filipleon54/hellen-example/boards/lewycustom-a/board/lewycustom-a.png

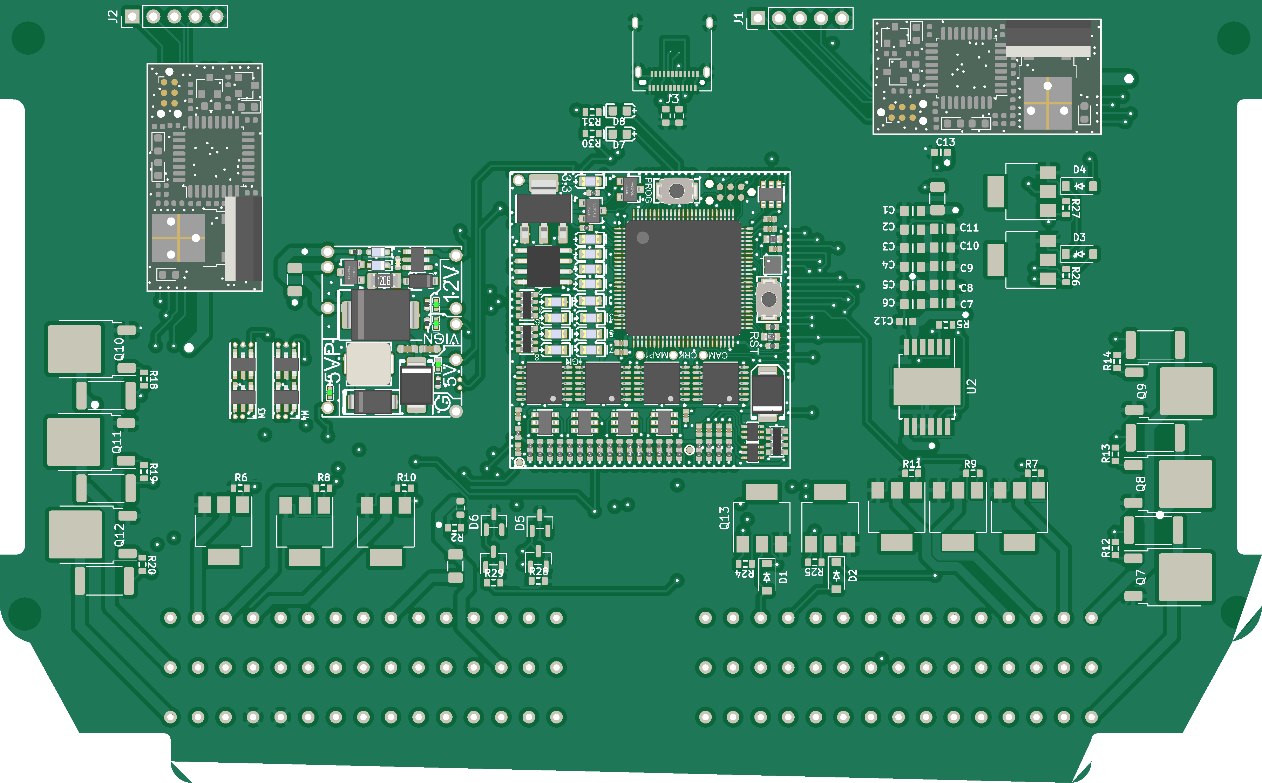
boards/lewycustom-a/board/lewycustom-a.png
