filipleon54/hellen-example/boards/lewycustom-a/board/misc/lewycustom-a-bottom.png

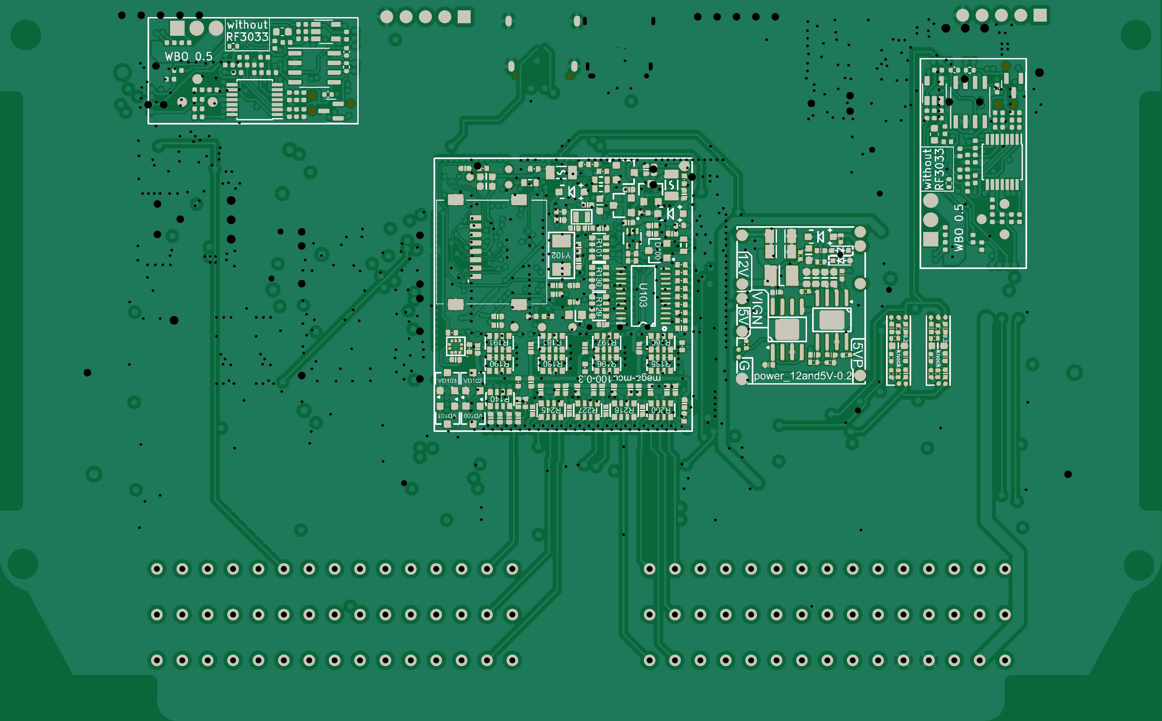
boards/lewycustom-a/board/misc/lewycustom-a-bottom.png
