filipleon54/hellen-example/boards/lewycustom-a/board/misc/lewycustom-a-outline.png

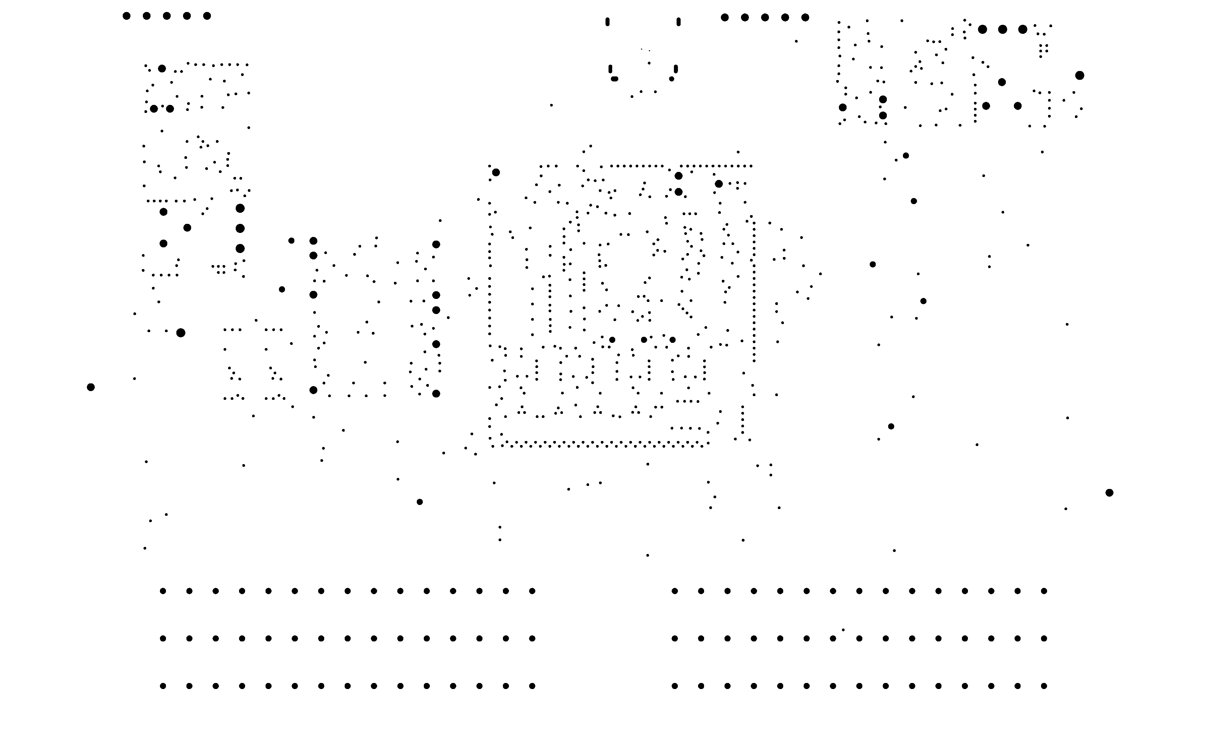
boards/lewycustom-a/board/misc/lewycustom-a-outline.png
