filipleon54/hellen-example/boards/lewycustom-a/board/misc/lewycustom-a-top.png

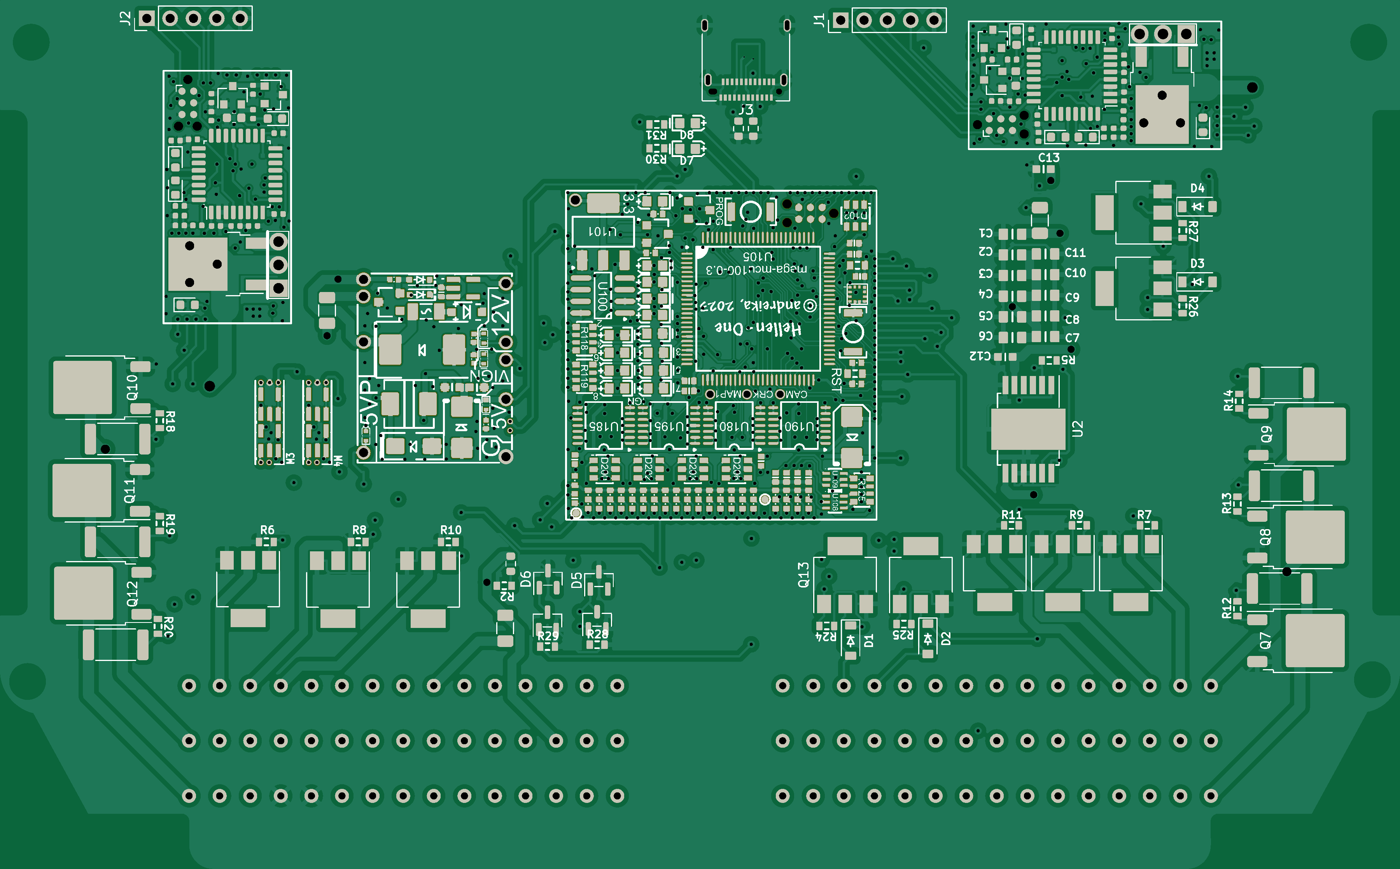
boards/lewycustom-a/board/misc/lewycustom-a-top.png
