filipleon54/hellen-example/boards/lewycustom-a/board/misc/lewycustom-a-components.png

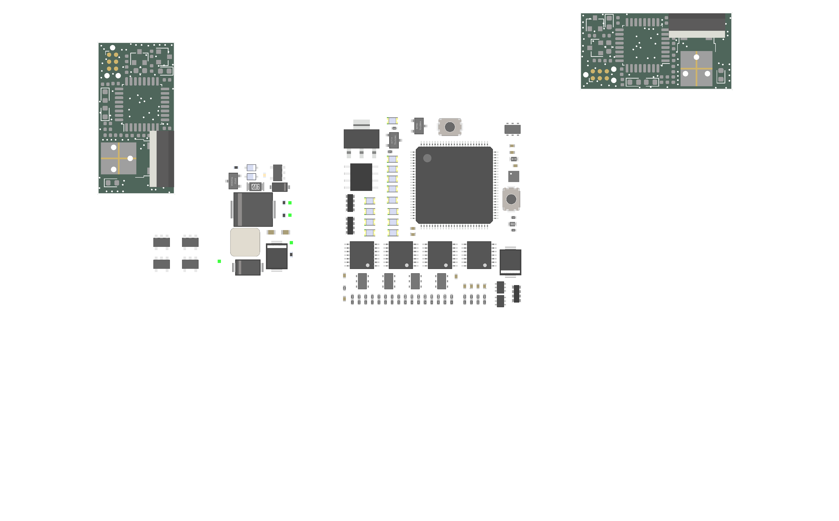
boards/lewycustom-a/board/misc/lewycustom-a-components.png
