filipleon54/hellen-example/boards/lewycustom-a/board/lewycustom-a-schematic.pdf

# File: ign.kicad_sch OUT- OUT+

# +5VA GND

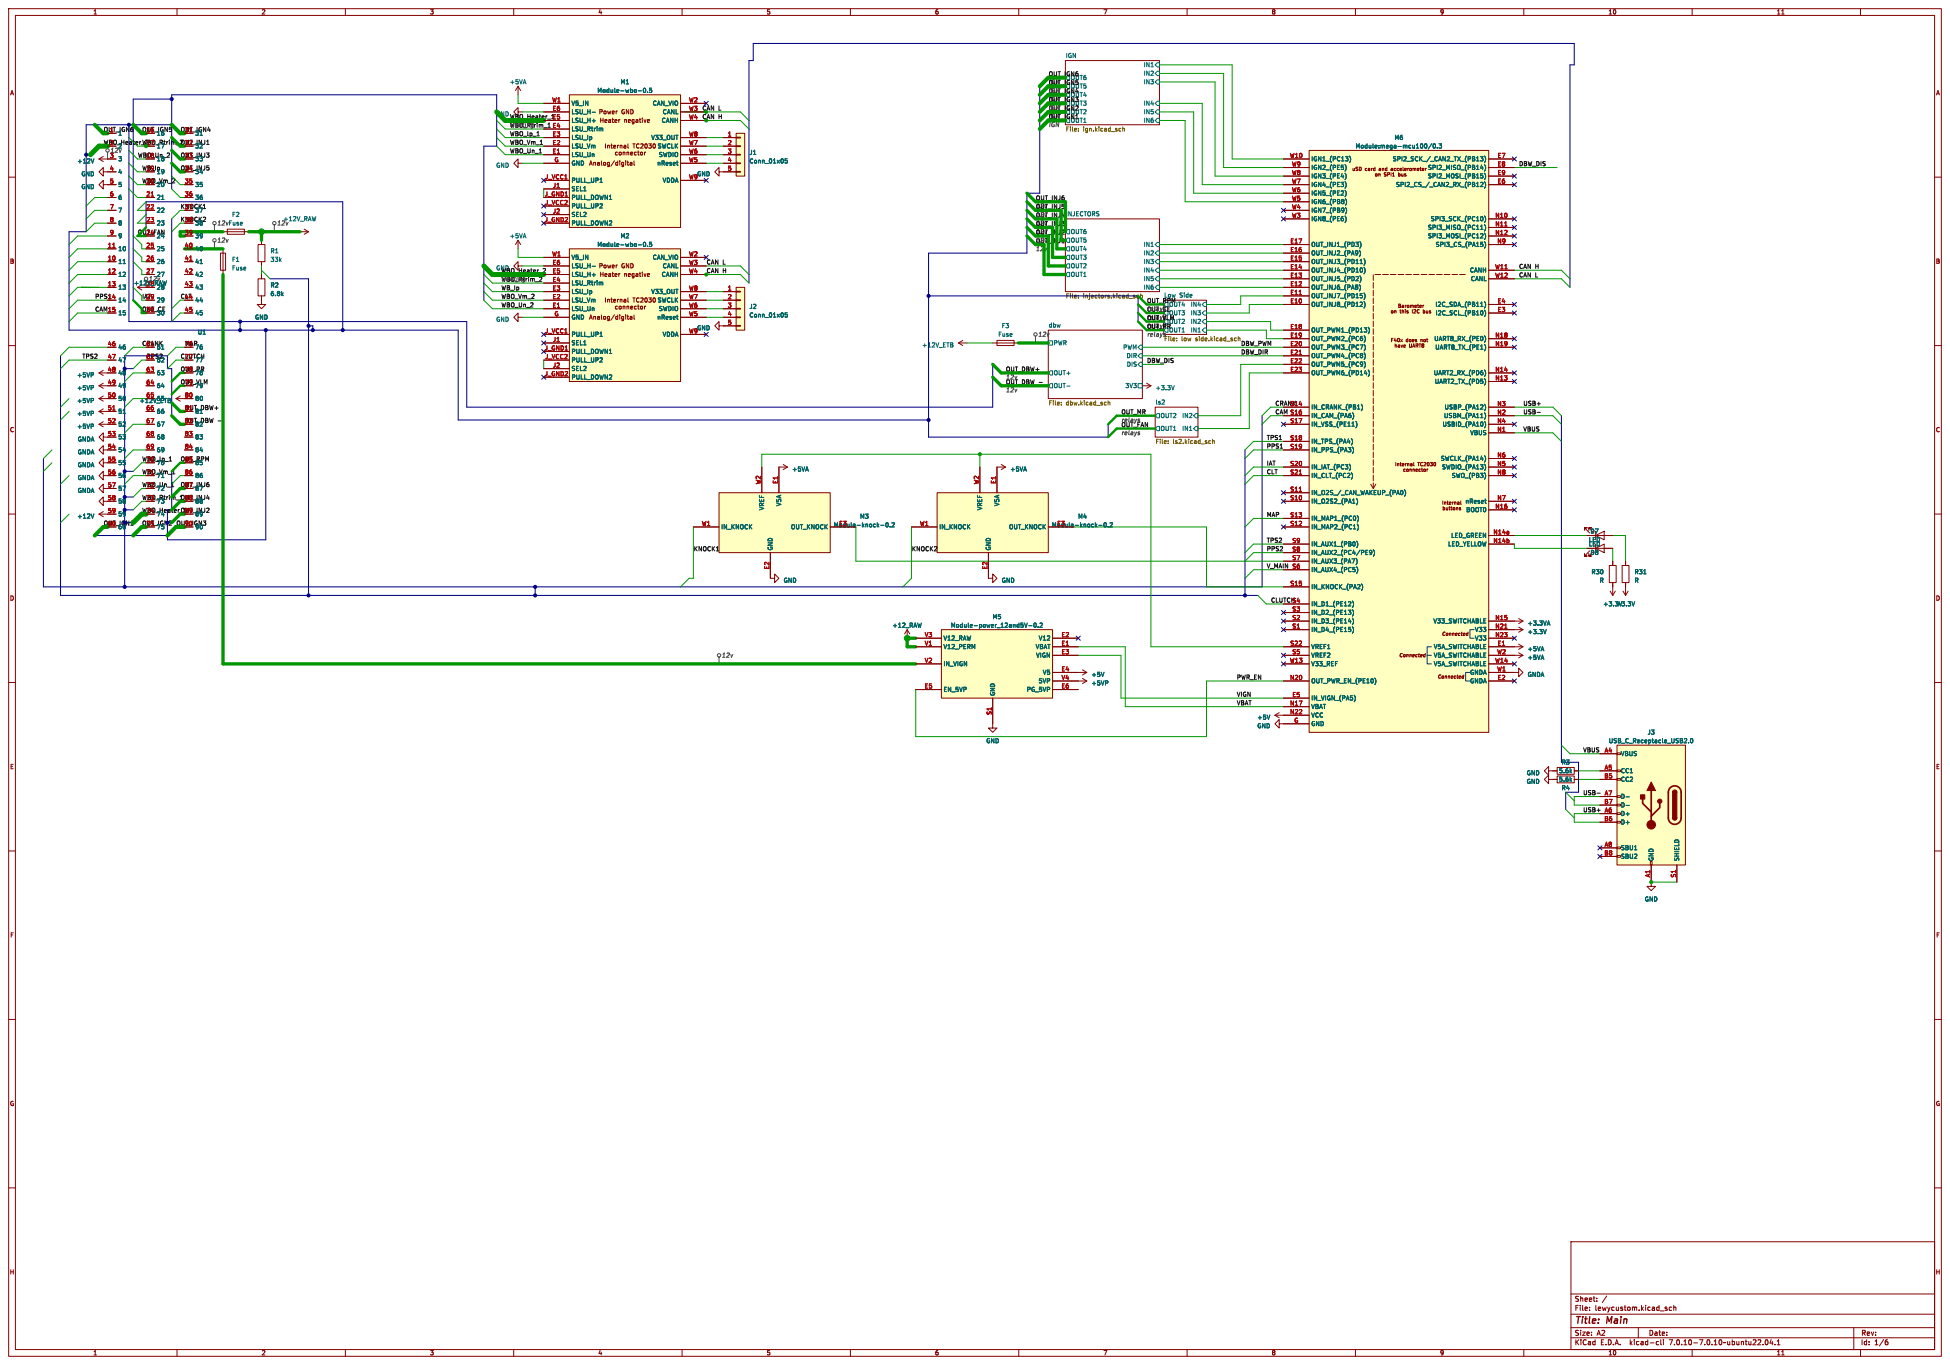
[picture p6: page 1]

F3 Fuse Analog/digital Heater negative Power GND

Low Side File: low side.kicad_sch OUT1

Analog/digital Heater negative Power GND

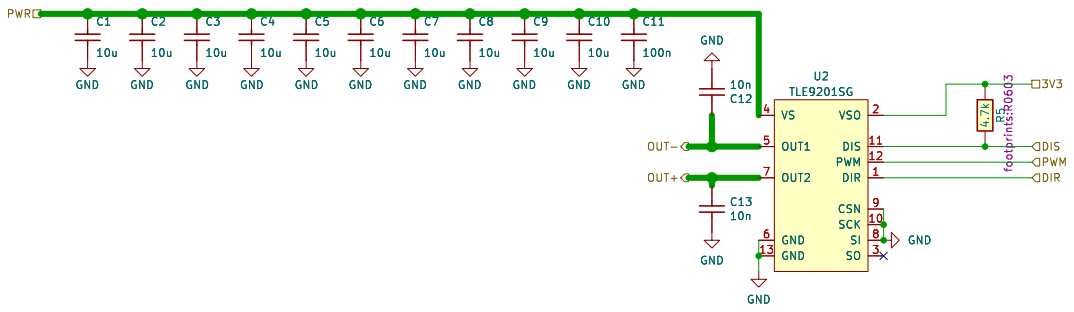
[picture p7: page 2]

Id: 2/6 Title: File: dbw.kicad_sch Sheet: /dbw/

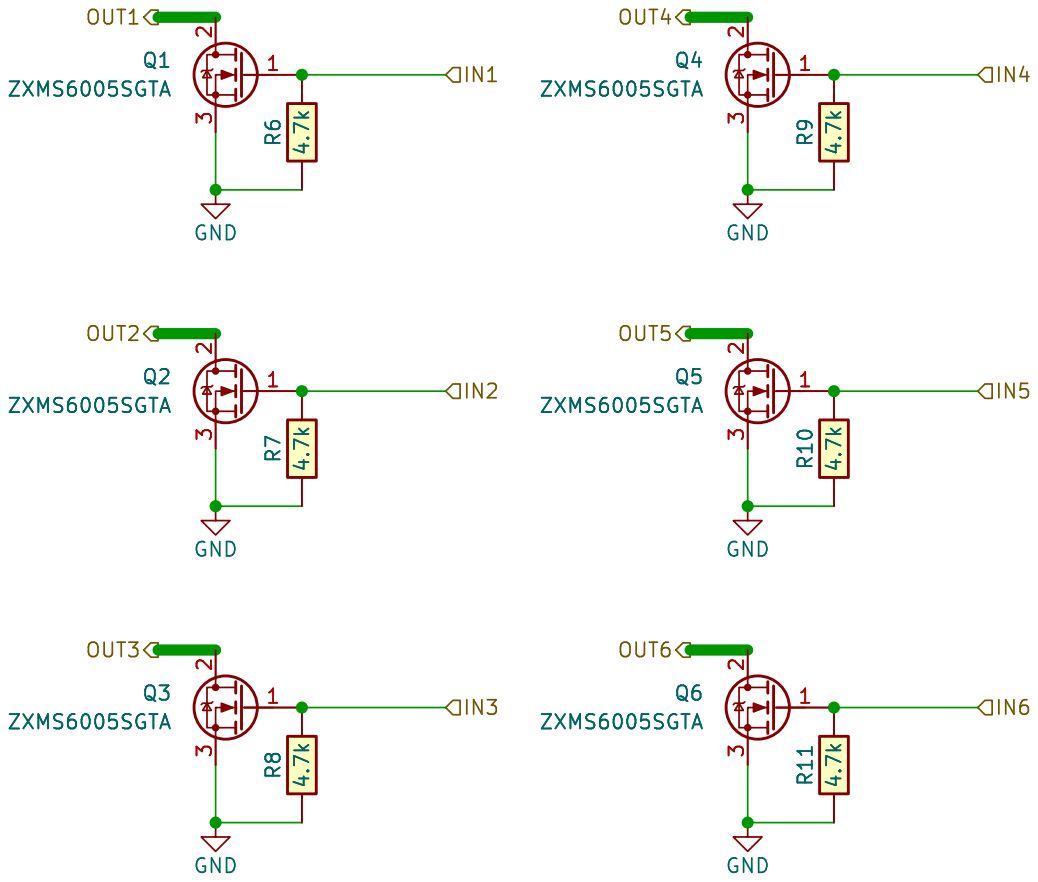
[picture p8: page 3]

Id: 3/6 Title: File: injectors.kicad_sch Sheet: /INJECTORS/ GND R⁶ 4.7k R⁷ 4.7k 1

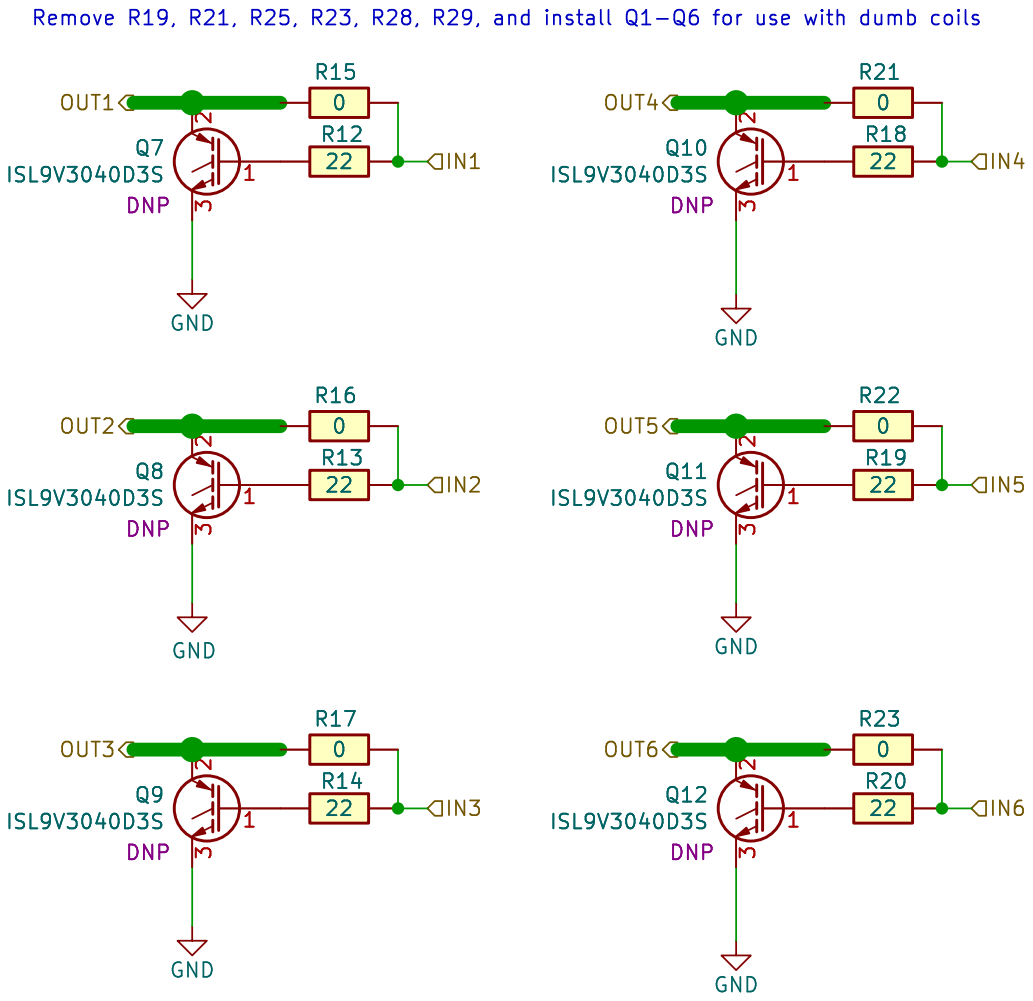
[picture p9: page 4]

Id: 4/6 Title: File: ign.kicad_sch Sheet: /IGN/

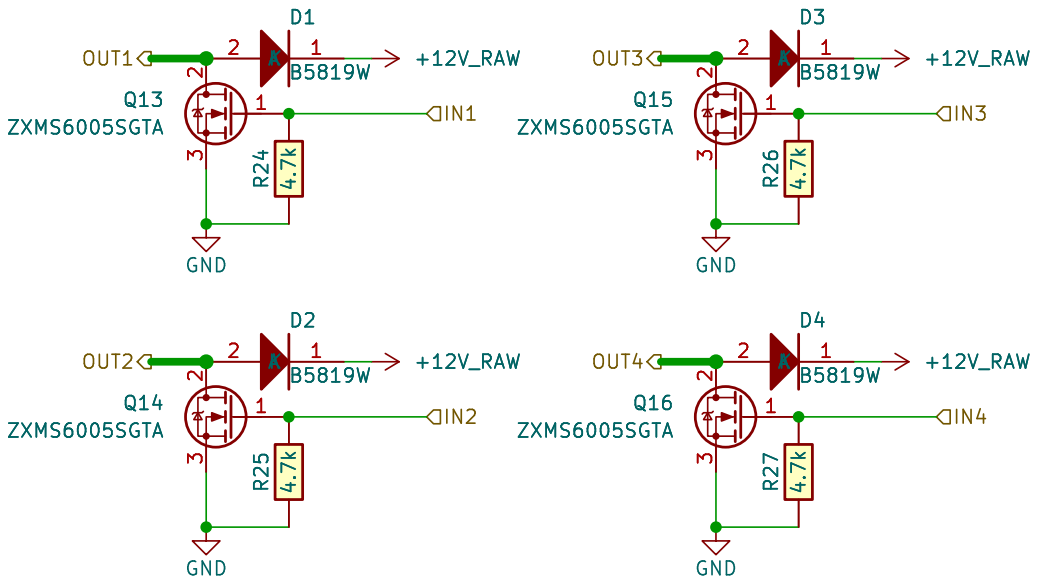
[picture p10: page 5]
D Date: KiCad; kicad-cli; 7.0.10-7.0.10~ubuntu22.04.1 Size: A4; Rev:; 2 3 Q16 ZXMS6005SGTA R24 4.7k 1; 2 3 Q13 ZXMS6005SGTA R25 4.7k K; +12V_RAW; GND; 2 3 Q15 ZXMS6005SGTA GND; +12V_RAW 1 A; D3B5819W R²⁶ 4.7k 1; 2 3 Q14 ZXMS6005SGTA GND; D4B5819W R²⁷ 4.7k; OUT3 OUT2 OUT1; OUT4; IN3 +12V_RAW; 2 R²⁷ 4.7k R²⁶ 4.7k; 2 Q16 ZXMS6005SGTA; 2 3 Q15 ZXMS6005SGTA; 2 3 +12V_RAW; 2 R²⁵ 4.7k R²⁴ 4.7k Q13 ZXMS6005SGTA 1; 2 Q14 ZXMS6005SGTA

Id: 5/6 Title: File: low side.kicad_sch Sheet: /Low Side/

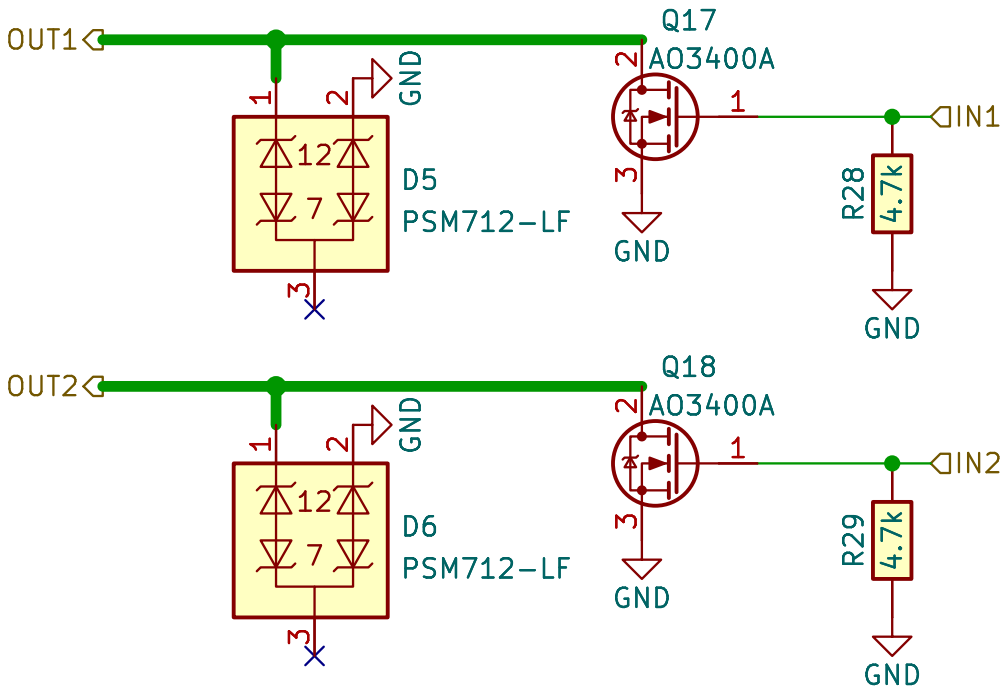
[picture p11: page 6]
D Date: KiCad; kicad-cli; 7.0.10-7.0.10~ubuntu22.04.1 Size: A4; Rev:; 2 3 Q17 AO3400A GND GND; 3 D5PSM712-LF GND R29 4.7k 12; IN1 OUT1 OUT2; 2 3 GND GND; D5PSM712-LF; 3 D6PSM712-LF; 2 3 GND

3 D6PSM712-LF GND GND R28 4.7k

3 GND GND R28 4.7k R29 4.7k GND Q18 AO3400A

Id: 6/6 Title: File: ls2.kicad_sch Sheet: /ls2/ GND

+3.3V C616

27k +


100n GND GND R⁶⁰⁸ ⁴⁷

1 PA4 10 PA5 11 PA6 12 PA7 13 PB0 14 PB1 15 VSS 16 VDDIO2 17 PA8 18 PA9 19 PF0 2 PA10 20 PA11 21 PA12 22 PA13 23 PA14 24 PA15 25 PB3 26 PB4 27 PB5 28 PB6 29 PF1 3 PB7 30 PB8 31 VSSA 32 NRST 4 VDDA

1u GND GND GND
+3.3V R⁶¹¹ ²⁰k R⁶¹⁰ ²⁰k GND

to ground to improve the routing
(floating pins by the software).

Heater negative Power GND

VDDA GND
Nernst Sense Voltage Buffer Nernst Internal Resistance Measurement

+3.3V C606 DNP GND
File: hellen1-wbo.kicad_sch Sheet: / rusefi.com V⁻ 11 V⁺



Hellen One : Power-Module interface

Reverse polarity and overvoltage protection
F410 V12_RAW

Vdd 4; Vss 6; MCP6004; GNDA; OUT1; OUT2; OUT3; OUT4; C180 PIC18001 100n; PIC18002 COC3; PIR18001; PIR18002; PIR18003; PIR18004; PIR18005; PIR18006; PIR18007; PIR18008; COR5; PIR18101; PIR18102; PIR18103; PIR18105; PIR18104; PIR18106; PIR18107; PIR18108; COR6; PIU18001; PIU18002; PIU18003; PIU18004; PIU18005; PIU18006; PIU18007; PIU18008; PIU18009; PIU180010; PIU180011; PIU180012; PIU180013; PIU180014; COU2; PIC18001; POOUT2; POOUT1; POOUT3; POOUT4; POIN1; POIN3 PIU18005; PIU180010 POIN4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

Vdd 4; Vss 6; MCP6004; GNDA; OUT1; OUT2; OUT3; OUT4; C185 PIC18501 100n; PIC18502 COC3; PIR18501; PIR18502; PIR18503; PIR18504; PIR18505; PIR18506; PIR18507; PIR18508; COR5; PIR18601; PIR18602; PIR18603; PIR18605; PIR18604; PIR18606; PIR18607; PIR18608; COR6; PIU18501; PIU18502; PIU18503; PIU18504; PIU18505; PIU18506; PIU18507; PIU18508; PIU18509; PIU185010; PIU185011; PIU185012; PIU185013; PIU185014; COU2; PIC18501; POOUT2; POOUT1; POOUT3; POOUT4; POIN1; POIN3 PIU18505; PIU185010 POIN4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

Vdd 4; Vss 6; MCP6004; GNDA; OUT1; OUT2; OUT3; OUT4; C190 PIC19001 100n; PIC19002 COC3; PIR19001; PIR19002; PIR19003; PIR19004; PIR19005; PIR19006; PIR19007; PIR19008; COR5; PIR19101; PIR19102; PIR19103; PIR19105; PIR19104; PIR19106; PIR19107; PIR19108; COR6; PIU19001; PIU19002; PIU19003; PIU19004; PIU19005; PIU19006; PIU19007; PIU19008; PIU19009; PIU190010; PIU190011; PIU190012; PIU190013; PIU190014; COU2; PIC19001; POOUT2; POOUT1; POOUT3; POOUT4; POIN1; POIN3 PIU19005; PIU190010 POIN4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

SPI_; VCC; 5 SPI_SCK; 7 SPI_O; lex MicroSD; _MIS


R143 populated: analog input O2S
R145 populated: WAKEUP by CAN

*VIGN input is unprotected!
*A21 is duplicated for ADC and EINT




D100 PESD1CAN; GND; TXD 1 GND 2 VCC 3; Vio; 5 RXD 4; CANL; 6 CANH; TJA1051T/3/1J; CAN_TX; CAN_RX; VCC; CANH; CANL C100 100n

VRE; _CRA; _CLT; IAT; _IAT; VIG; nRes; VBAT; SWCL; SPI2; _MIS; SPI3; I2C_SCL; SPI1; PWR_; GRE; u mcu.Sch; _IGN; 8.Sch; _can can.Sch; d.Sch; nRS; USB_; P USB_; USBI; A I2C_SCL UART8_RX UART8_TX UART2_RX UART2_TX; N VBAT; VCC; ACC_SC; ACC_; ACC_MIS; ACC_MO; BARO; sen; ors.Sc; LVC1; VBU; wer.Sch; USBID (PA; USBM (PA; USBP (PA; 8 SWDIO (PA13); N5 SWCLK (PA14); N6 nReset; _SCK (PC1; _MISO (PC1; _MOSI (PC1; I2C_SCL (PB1; 3 I2C_SDA (PB11); E4 UART2_TX (PD5); _SCK; _MISO (PB1; _MOSI (PB1; _PWM2 (PC6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

USBM USBP USBID VBUS

### COR2

Vdd 4; Vss 6; MCP6004; GNDA; IN1 (CRNK); OUT1; OUT2; OUT3; OUT4; C195 PIC19501 100n; PIC19502 COC2; PIR19502; PIR19501; PIR19601; PIR19602; PIR19603; PIR19604; PIR19605; PIR19606; PIR19607; PIR19608; COR3; PIR19701; PIR19702; PIR19703; PIR19705; PIR19704; PIR19706; PIR19707; PIR19708; COR4; PIU19501; PIU19502; PIU19503; PIU19504; PIU19505; PIU19506; PIU19507; PIU19508; PIU19509; PIU195010; PIU195011; PIU195012; PIU195013; PIU195014; COU1; PIC19501; POOUT1; POOUT2; POOUT3; POOUT4; POIN1 (CRNK)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

More accurate threshold for "raw" connection of VR sensors


RES 5; GND(1) 6; GND(2); 7 GND(3); 8 VDD; 9 VDD_IO; INT_2 11; INT_1 12; U106 LIS2DH12TR; VDD 10; INT DRDY; RES 3; Vdd IO 1; GND; LPS22HBTR; ACC_SCK ACC_CS ACC_MISO ACC_MOSI; BARO_SCL BARO_SDA

SCL/SPC 1
SDO/SA0 3
SDA/SDI/SDO 4

SCL/SPC 2
SDO/SA0 5
