filipleon54/hellen-example/boards/lewycustom-a/frame/custom-schematic.pdf

F3 Fuse Analog/digital Heater negative Power GND

Low Side File: low side.kicad_sch OUT1

Analog/digital Heater negative Power GND


Id: 2/6 Title: File: dbw.kicad_sch Sheet: /dbw/



Id: 4/6 Title: File: ign.kicad_sch Sheet: /IGN/


Id: 5/6 Title: File: low side.kicad_sch Sheet: /Low Side/


Id: 6/6 Title: File: ls2.kicad_sch Sheet: /ls2/ GND
