filipleon54/hellen-example/lewycustom.kicad_pcb

## KiCad design lewycustom.kicad_pcb (2024-01-28)

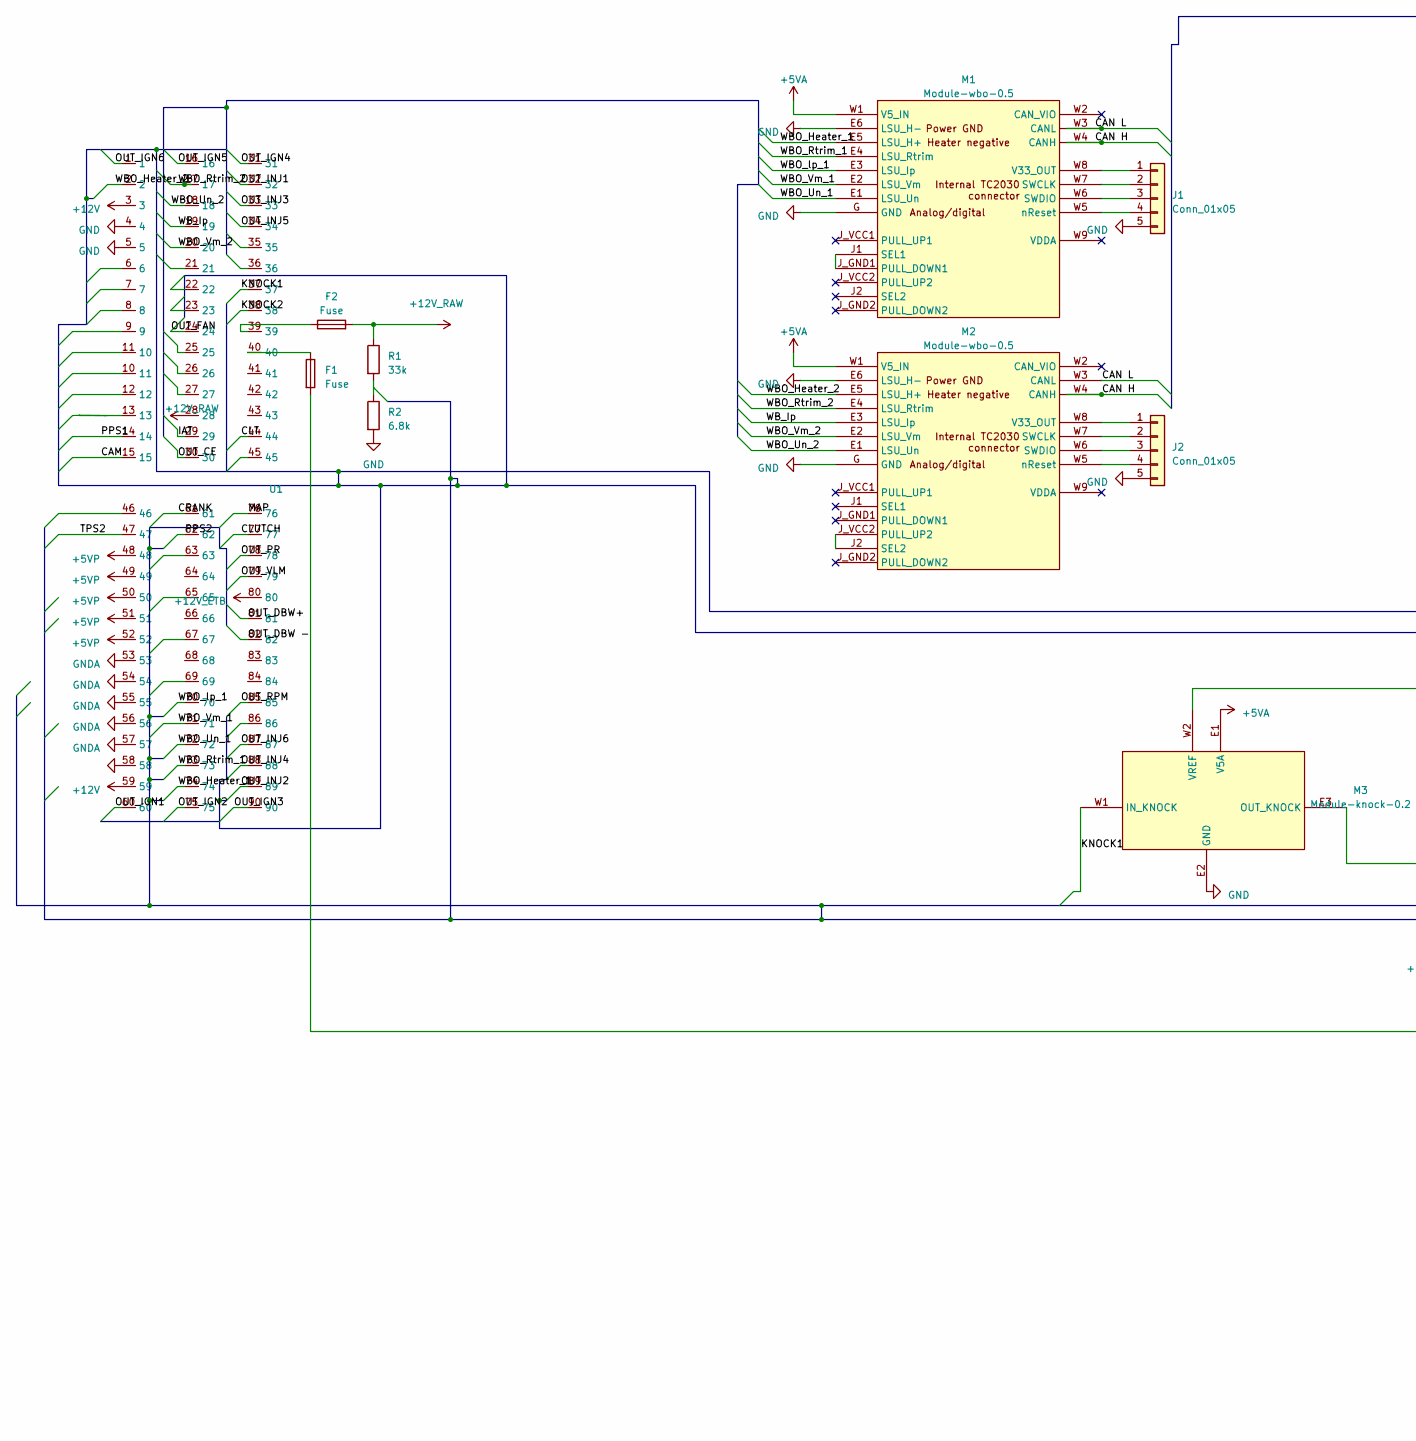
[picture p28: schematic lewycustom.kicad_sch, Main, part in row 1, column 1]

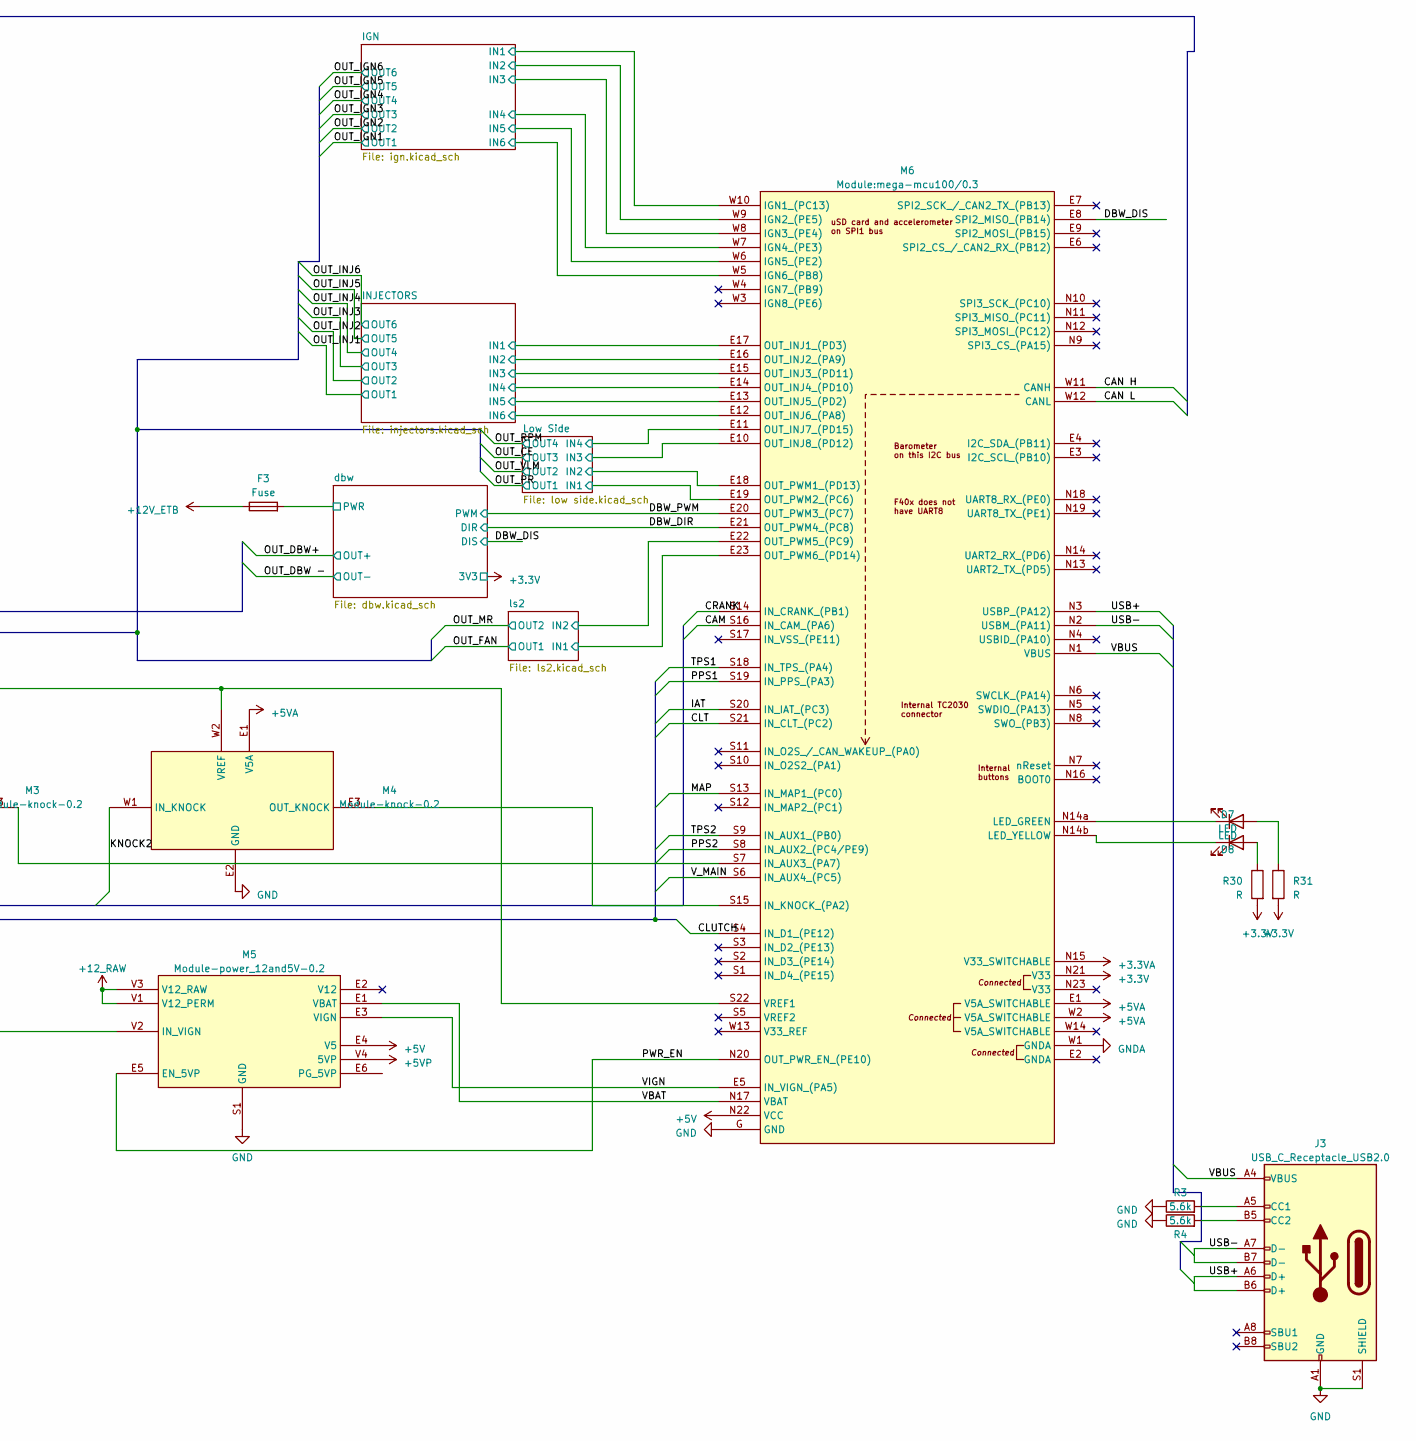
[picture p29: schematic lewycustom.kicad_sch, Main, part in row 1, column 2]

Parts:
D7, D8: LED; LED-0603
F1, F2, F3: Fuse; Fuse_1206_3216Metric
J1, J2: Conn_01x05; PinHeader_1x05_P2.54mm_Vertical
J3: USB_C_Receptacle_USB2.0; USB_C_Receptacle_Amphenol_12401610E4-2A
M1, M2: Module-wbo-0.5; wbo
M3, M4: Module-knock-0.2; knock
M5: Module-power_12and5V-0.2; power_12and5V
M6: Module:mega-mcu100/0.3; mega-mcu100
R1: 33k; R_0603_1608Metric
R2: 6.8k; R0603
R3, R4: 5.6k; R_0603_1608Metric
R30, R31: R; R0603
U1: 90_pin_ecu

Connections:
+3.3V: M6.N21 (V33), R30.2, R31.2; also elsewhere on the board
+3.3VA: M6.N15 (V33_SWITCHABLE)
+5V: M5.E4 (V5), M6.N22 (VCC)
+5VA: M1.W1 (V5_IN), M2.W1 (V5_IN), M3.E1 (V5A), M4.E1 (V5A), M6.E1 (V5A_SWITCHABLE), M6.W2 (V5A_SWITCHABLE)
+5VP: M5.V4 (5VP), U1.48, U1.49, U1.50, U1.51, U1.52
+12V_ETB: F3.1, U1.80
/CAM: M6.S16 (IN_CAM_(PA6)), U1.15
/CAN H: M1.W4 (CANH), M2.W4 (CANH), M6.W11 (CANH)
/CAN L: M1.W3 (CANL), M2.W3 (CANL), M6.W12 (CANL)
/CLT: M6.S21 (IN_CLT_(PC2)), U1.44
/CLUTCH: M6.S4 (IN_D1_(PE12)), U1.77
/CRANK: M6.S14 (IN_CRANK_(PB1)), U1.61
/DBW_DIR: M6.E21 (OUT_PWM4_(PC8)); also elsewhere on the board
/DBW_DIS: M6.E8 (SPI2_MISO_(PB14)); also elsewhere on the board
/DBW_PWM: M6.E20 (OUT_PWM3_(PC7)); also elsewhere on the board
/IAT: M6.S20 (IN_IAT_(PC3)), U1.29
/IGN/IN1: M6.W10 (IGN1_(PC13)); also elsewhere on the board
/IGN/IN2: M6.W9 (IGN2_(PE5)); also elsewhere on the board
/IGN/IN3: M6.W8 (IGN3_(PE4)); also elsewhere on the board
/IGN/IN4: M6.W7 (IGN4_(PE3)); also elsewhere on the board
/IGN/IN5: M6.W6 (IGN5_(PE2)); also elsewhere on the board
/IGN/IN6: M6.W5 (IGN6_(PB8)); also elsewhere on the board
/INJECTORS/IN1: M6.E17 (OUT_INJ1_(PD3)); also elsewhere on the board
/INJECTORS/IN2: M6.E16 (OUT_INJ2_(PA9)); also elsewhere on the board
/INJECTORS/IN3: M6.E15 (OUT_INJ3_(PD11)); also elsewhere on the board
/INJECTORS/IN4: M6.E14 (OUT_INJ4_(PD10)); also elsewhere on the board
/INJECTORS/IN5: M6.E13 (OUT_INJ5_(PD2)); also elsewhere on the board
/INJECTORS/IN6: M6.E12 (OUT_INJ6_(PA8)); also elsewhere on the board
/KNOCK1: M3.W1 (IN_KNOCK), U1.37
/KNOCK2: M4.W1 (IN_KNOCK), U1.38
/Low Side/IN1: M6.E19 (OUT_PWM2_(PC6)); also elsewhere on the board
/Low Side/IN2: M6.E18 (OUT_PWM1_(PD13)); also elsewhere on the board
/Low Side/IN3: M6.E10 (OUT_INJ8_(PD12)); also elsewhere on the board
/Low Side/IN4: M6.E11 (OUT_INJ7_(PD15)); also elsewhere on the board
/MAP: M6.S13 (IN_MAP1_(PC0)), U1.76
/OUT_CE: U1.30; also elsewhere on the board
/OUT_DBW -: U1.82; also elsewhere on the board
/OUT_DBW+: U1.81; also elsewhere on the board
/OUT_FAN: U1.24; also elsewhere on the board
/OUT_IGN1: U1.60; also elsewhere on the board
/OUT_IGN2: U1.75; also elsewhere on the board
/OUT_IGN3: U1.90; also elsewhere on the board
/OUT_IGN4: U1.31; also elsewhere on the board
/OUT_IGN5: U1.16; also elsewhere on the board
/OUT_IGN6: U1.1; also elsewhere on the board
/OUT_INJ1: U1.32; also elsewhere on the board
/OUT_INJ2: U1.89; also elsewhere on the board
/OUT_INJ3: U1.33; also elsewhere on the board
/OUT_INJ4: U1.88; also elsewhere on the board
/OUT_INJ5: U1.34; also elsewhere on the board
/OUT_INJ6: U1.87; also elsewhere on the board
/OUT_PR: U1.78; also elsewhere on the board
/OUT_RPM: U1.85; also elsewhere on the board
/OUT_VLM: U1.79; also elsewhere on the board
/PPS1: M6.S19 (IN_PPS_(PA3)), U1.14
/PPS2: M6.S8 (IN_AUX2_(PC4/PE9)), U1.62
/PWR_EN: M5.E5 (EN_5VP), M6.N20 (OUT_PWR_EN_(PE10))
/TPS1: M6.S18 (IN_TPS_(PA4))
/TPS2: M6.S9 (IN_AUX1_(PB0)), U1.47
/USB+: J3.A6 (D+), J3.B6 (D+), M6.N3 (USBP_(PA12))
/USB-: J3.A7 (D-), J3.B7 (D-), M6.N2 (USBM_(PA11))
/VBAT: M5.E1 (VBAT), M6.N17 (VBAT)
/VBUS: J3.A4 (VBUS), J3.A9 (VBUS), J3.B4 (VBUS), J3.B9 (VBUS), M6.N1 (VBUS)
/VIGN: M5.E3 (VIGN), M6.E5 (IN_VIGN_(PA5))
/V_MAIN: M6.S6 (IN_AUX4_(PC5))
/WBO_Heater_1: M1.E5 (LSU_H+), U1.74
/WBO_Heater_2: M2.E5 (LSU_H+), U1.2
/WBO_Rtrim_1: M1.E4 (LSU_Rtrim), U1.73
/WBO_Rtrim_2: M2.E4 (LSU_Rtrim), U1.17
/WBO_Un_1: M1.E1 (LSU_Un), U1.72
/WBO_Un_2: M2.E1 (LSU_Un), U1.18
/WBO_Vm_1: M1.E2 (LSU_Vm), U1.71
/WBO_Vm_2: M2.E2 (LSU_Vm), U1.20
/WBO_lp_1: M1.E3 (LSU_Ip), U1.70
/WB_Ip: M2.E3 (LSU_Ip), U1.19
/dbw/PWR: F3.2; also elsewhere on the board
/ls2/IN1: M6.E23 (OUT_PWM6_(PD14)); also elsewhere on the board
/ls2/IN2: M6.E22 (OUT_PWM5_(PC9)); also elsewhere on the board
GND: J1.5, J2.5, J3.A1 (GND), J3.A12 (GND), J3.B1 (GND), J3.B12 (GND), J3.S1 (SHIELD), M1.E6 (LSU_H-), M1.G (GND), M2.E6 (LSU_H-), M2.G (GND), M3.E2 (GND), M4.E2 (GND), M5.S1 (GND), M6.G (GND), R2.2, R3.1, R4.1, U1.4, U1.5; also elsewhere on the board
GNDA: M6.W1 (GNDA), U1.53, U1.54, U1.55, U1.56, U1.57, U1.58
unnamed: D7.2 (A), R30.1
unnamed: D7.1 (K), M6.N14b (LED_YELLOW)
unnamed: D8.2 (A), R31.1
unnamed: D8.1 (K), M6.N14a (LED_GREEN)
unnamed: F1.1, U1.40
unnamed: F2.1, U1.39
unnamed: J1.1, M1.W8 (V33_OUT)
unnamed: J1.2, M1.W7 (SWCLK)
unnamed: J1.3, M1.W6 (SWDIO)
unnamed: J1.4, M1.W5 (nReset)
unnamed: J2.1, M2.W8 (V33_OUT)
unnamed: J2.2, M2.W7 (SWCLK)
unnamed: J2.3, M2.W6 (SWDIO)
unnamed: J2.4, M2.W5 (nReset)
unnamed: J3.A5 (CC1), R3.2
unnamed: J3.B5 (CC2), R4.2
unnamed: M1.J1 (SEL1), M1.J_GND1 (PULL_DOWN1)
unnamed: M2.J2 (SEL2), M2.J_VCC2 (PULL_UP2)
unnamed: M3.E3 (OUT_KNOCK), M6.S7 (IN_AUX3_(PA7))
unnamed: M3.W2 (VREF), M4.W2 (VREF), M6.S22 (VREF1)
unnamed: M4.E3 (OUT_KNOCK), M6.S15 (IN_KNOCK_(PA2))
unnamed: F1.2, M5.V2 (IN_VIGN)
unnamed: R1.2, R2.1

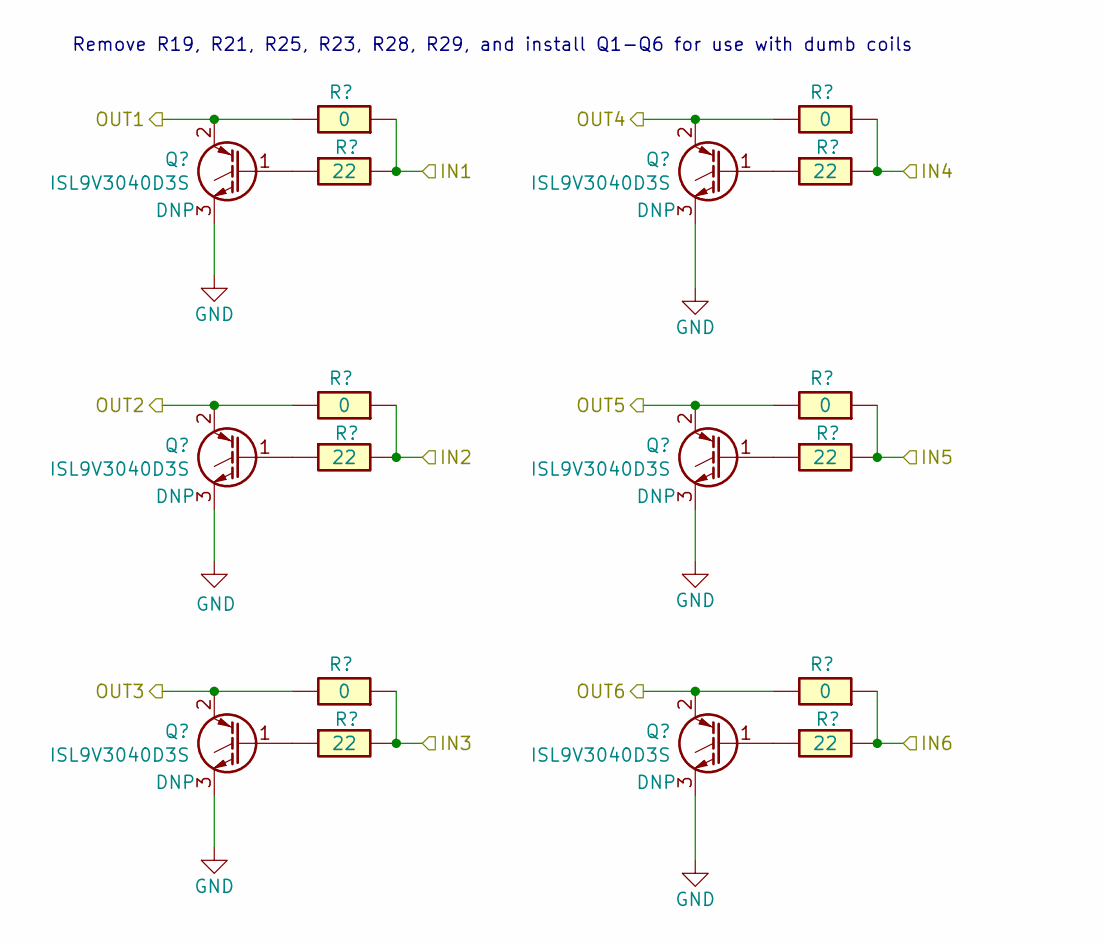
[picture p30: schematic ign.kicad_sch]

Parts:
Q7, Q8, Q9, Q10, Q11, Q12: ISL9V3040D3S; TO-252-2
R12, R13, R14, R18, R19, R20: 22; R0603; LCSC C23345
R15, R16, R17, R21, R22, R23: 0; R_2512_6332Metric; LCSC C25469

Connections:
/IGN/IN1: R12.2, R15.1; also elsewhere on the board
/IGN/IN2: R13.2, R16.1; also elsewhere on the board
/IGN/IN3: R14.2, R17.1; also elsewhere on the board
/IGN/IN4: R18.2, R21.1; also elsewhere on the board
/IGN/IN5: R19.2, R22.1; also elsewhere on the board
/IGN/IN6: R20.2, R23.1; also elsewhere on the board
/OUT_IGN1: Q7.2 (C), R15.2; also elsewhere on the board
/OUT_IGN2: Q8.2 (C), R16.2; also elsewhere on the board
/OUT_IGN3: Q9.2 (C), R17.2; also elsewhere on the board
/OUT_IGN4: Q10.2 (C), R21.2; also elsewhere on the board
/OUT_IGN5: Q11.2 (C), R22.2; also elsewhere on the board
/OUT_IGN6: Q12.2 (C), R23.2; also elsewhere on the board
GND: Q7.3 (E), Q8.3 (E), Q9.3 (E), Q10.3 (E), Q11.3 (E), Q12.3 (E); also elsewhere on the board
unnamed: Q7.1 (G), R12.1
unnamed: Q8.1 (G), R13.1
unnamed: Q9.1 (G), R14.1
unnamed: Q10.1 (G), R18.1
unnamed: Q11.1 (G), R19.1
unnamed: Q12.1 (G), R20.1

Notes on the sheet:
Remove R19, R21, R25, R23, R28, R29, and install Q1-Q6 for use with dumb coils

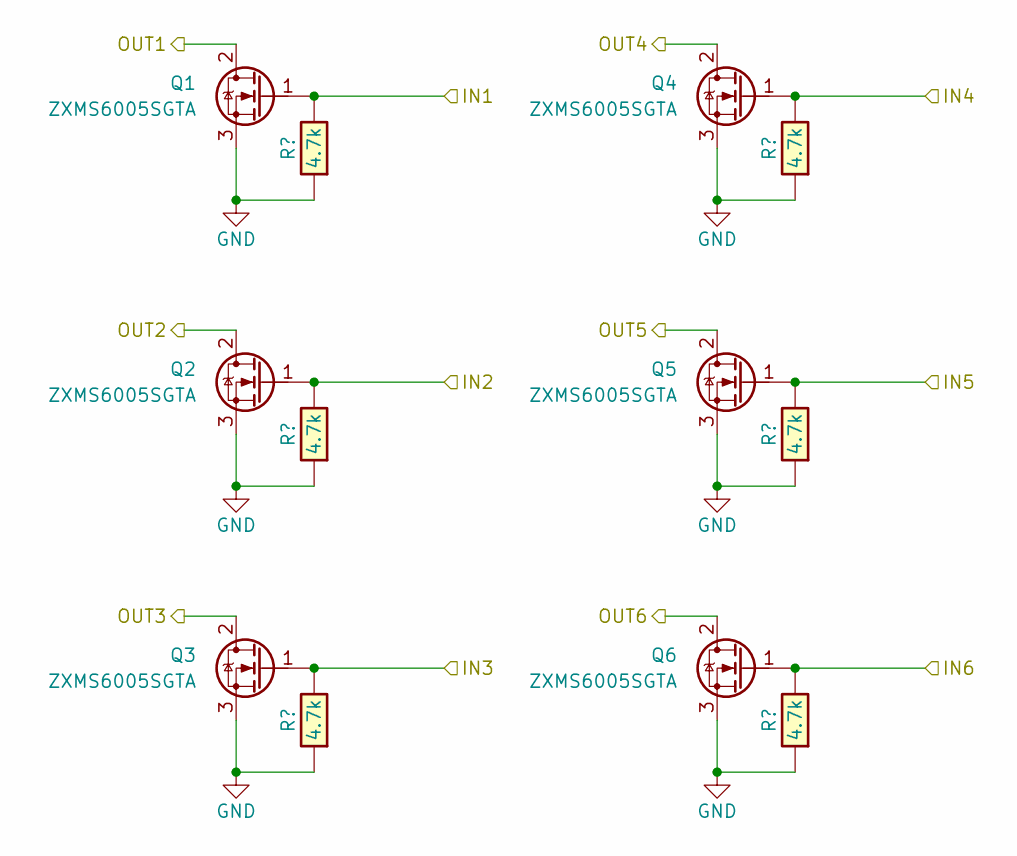
[picture p31: schematic injectors.kicad_sch]

Parts:
Q1, Q2, Q3, Q4, Q5, Q6: ZXMS6005SGTA; SOT-223; LCSC C174042
R6, R7, R8, R9, R10, R11: 4.7k; R0603; LCSC C23162

Connections:
/INJECTORS/IN1: Q1.1 (G), R6.2; also elsewhere on the board
/INJECTORS/IN2: Q2.1 (G), R7.2; also elsewhere on the board
/INJECTORS/IN3: Q3.1 (G), R8.2; also elsewhere on the board
/INJECTORS/IN4: Q4.1 (G), R9.2; also elsewhere on the board
/INJECTORS/IN5: Q5.1 (G), R10.2; also elsewhere on the board
/INJECTORS/IN6: Q6.1 (G), R11.2; also elsewhere on the board
/OUT_INJ1: Q1.2 (D); also elsewhere on the board
/OUT_INJ2: Q2.2 (D); also elsewhere on the board
/OUT_INJ3: Q3.2 (D); also elsewhere on the board
/OUT_INJ4: Q4.2 (D); also elsewhere on the board
/OUT_INJ5: Q5.2 (D); also elsewhere on the board
/OUT_INJ6: Q6.2 (D); also elsewhere on the board
GND: Q1.3 (S), Q2.3 (S), Q3.3 (S), Q4.3 (S), Q5.3 (S), Q6.3 (S), R6.1, R7.1, R8.1, R9.1, R10.1, R11.1; also elsewhere on the board

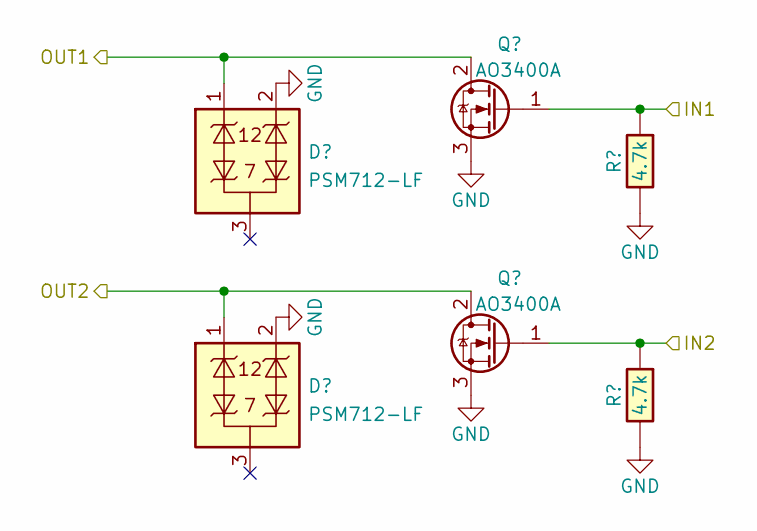
[picture p32: schematic ls2.kicad_sch]

Parts:
D5, D6: PSM712-LF; SOT-23; LCSC C32677
Q17, Q18: AO3400A; SOT-23; LCSC C20917
R28, R29: 4.7k; R0603; LCSC C23162

Connections:
/OUT_FAN: D5.1, Q17.2 (D); also elsewhere on the board
/OUT_MR: D6.1, Q18.2 (D)
/ls2/IN1: Q17.1 (G), R28.1; also elsewhere on the board
/ls2/IN2: Q18.1 (G), R29.1; also elsewhere on the board
GND: D5.2, D6.2, Q17.3 (S), Q18.3 (S), R28.2, R29.2; also elsewhere on the board

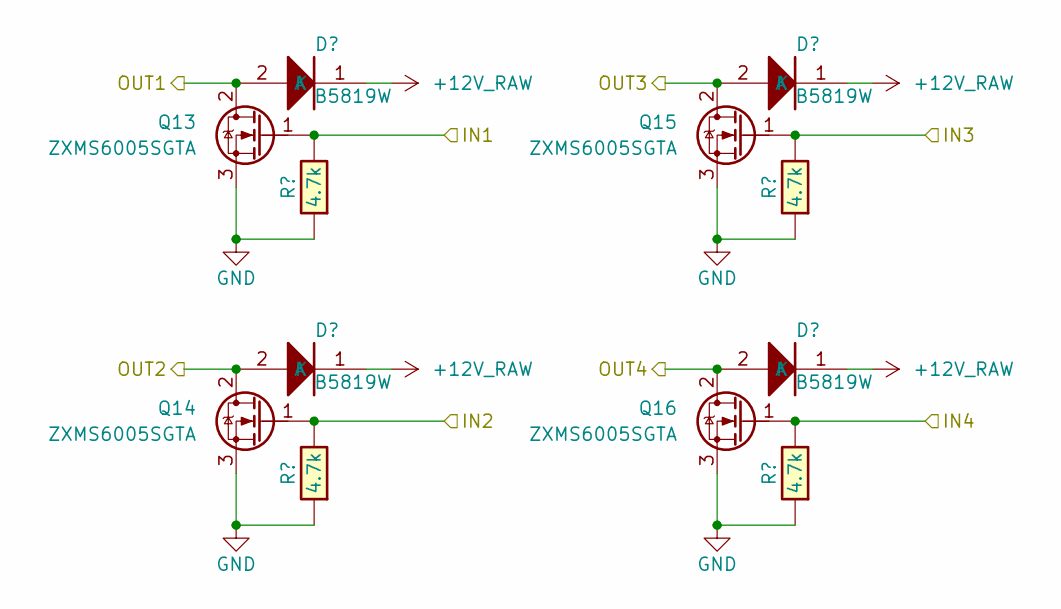
[picture p33: schematic low side.kicad_sch]

Parts:
D1, D2, D3, D4: B5819W; SOD-123; LCSC C8598
Q13, Q14, Q15, Q16: ZXMS6005SGTA; SOT-223; LCSC C174042
R24, R25, R26, R27: 4.7k; R0603; LCSC C23162

Connections:
+12V_RAW: D1.1 (K), D2.1 (K), D3.1 (K), D4.1 (K)
/Low Side/IN1: Q13.1 (G), R24.2; also elsewhere on the board
/Low Side/IN2: Q14.1 (G), R25.2; also elsewhere on the board
/Low Side/IN3: Q15.1 (G), R26.2; also elsewhere on the board
/Low Side/IN4: Q16.1 (G), R27.2; also elsewhere on the board
/OUT_CE: D3.2 (A), Q15.2 (D); also elsewhere on the board
/OUT_PR: D1.2 (A), Q13.2 (D); also elsewhere on the board
/OUT_RPM: D4.2 (A), Q16.2 (D); also elsewhere on the board
/OUT_VLM: D2.2 (A), Q14.2 (D); also elsewhere on the board
GND: Q13.3 (S), Q14.3 (S), Q15.3 (S), Q16.3 (S), R24.1, R25.1, R26.1, R27.1; also elsewhere on the board

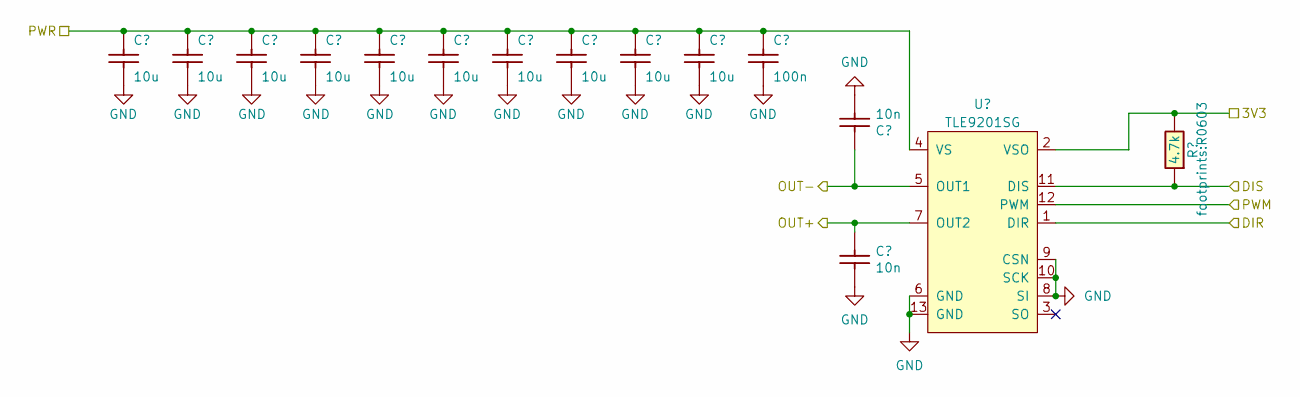
[picture p34: schematic dbw.kicad_sch]

Parts:
C1, C2, C3, C4, C5, C6, C7, C8, C9, C10: 10u; C0805; LCSC C15850
C11: 100n; C0805; LCSC C14663
C12, C13: 10n; C0603; LCSC C57112
R5: 4.7k; R0603; LCSC C23162
U2: TLE9201SG; Infineon_PG-DSO-12-11; LCSC C112633

Connections:
+3.3V: R5.2, U2.2 (VSO); also elsewhere on the board
/DBW_DIR: U2.1 (DIR); also elsewhere on the board
/DBW_DIS: R5.1, U2.11 (DIS); also elsewhere on the board
/DBW_PWM: U2.12 (PWM); also elsewhere on the board
/OUT_DBW -: C12.2, U2.5 (OUT1); also elsewhere on the board
/OUT_DBW+: C13.2, U2.7 (OUT2); also elsewhere on the board
/dbw/PWR: C1.2, C2.2, C3.2, C4.2, C5.2, C6.2, C7.2, C8.2, C9.2, C10.2, C11.2, U2.4 (VS); also elsewhere on the board
GND: C1.1, C2.1, C3.1, C4.1, C5.1, C6.1, C7.1, C8.1, C9.1, C10.1, C11.1, C12.1, C13.1, U2.6 (GND), U2.8 (SI), U2.9 (CSN), U2.10 (SCK), U2.13 (GND); also elsewhere on the board

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
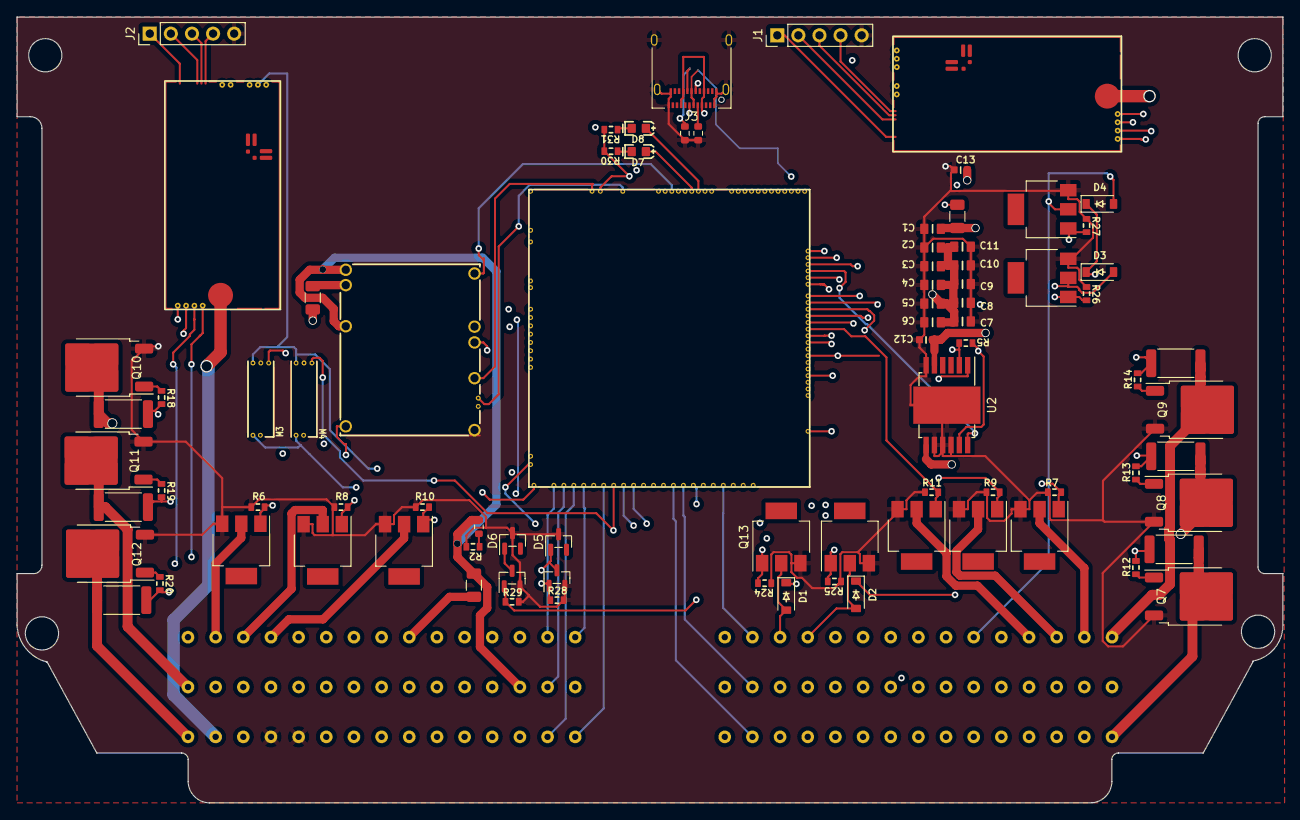
[picture p35: board lewycustom.kicad_pcb from above]

Board: 4 copper layers, 152.4 x 94.6 mm, 84 parts (0 on the bottom side), 109 nets.
