filipleon54/hellen-example/(commit log)

2024-01-27 [skip actions] Auto-generated board v2.1
    [lewycustom-B_Cu.gbl, lewycustom-B_Mask.gbs, lewycustom-B_Paste.gbp, lewycustom-B_Silkscreen.gbo, lewycustom-Edge_Cuts.gm1, lewycustom-F_Cu.gtl, lewycustom-F_Mask.gts, lewycustom-F_Paste.gtp]
2024-02-03 Update and rename bom_replace_xxxyyy-a.csv to bom_replace_lewycustom-a.csv
    [bom_replace_lewycustom-a.csv, bom_replace_xxxyyy-a.csv]
